SpdPnd98/EAWebSite/Characters_files/README.md

# Printed files

Below are the files we used to decorate our entertainment ship.

We have chosen a ```Pirate Theme``` to complement a fun and entertaining design

Credits to all the authors in Thingiverse that put their models in the public domain.
