SpdPnd98/EAWebSite/tim.md

### 11/02/2019

Team Bravo has finished making the battery indicator of the lipo battery pack

This battery indicator reads the voltage of the battery and shows its state by lighting up an LED in three different states

When we measured the battery at full charge, it reads 11.1V

We found that 3 batteries are in a lipo battery pack, hence the nominal voltage of one battery is 3.7V 

Components needed: 
                   
                   Stripboard
                   
                   Jumper wires
                   
                   82k resistor
                   
                   100k resistor 
                   
                   1 green led 

Since 11.1V cannot be supplied to the analog pin of the arduino because the pins can only receive an input of maximum 5 volts, we have decided to build a voltage divider with two resistors

Schematic of the circuit when simulated with a breadboard:

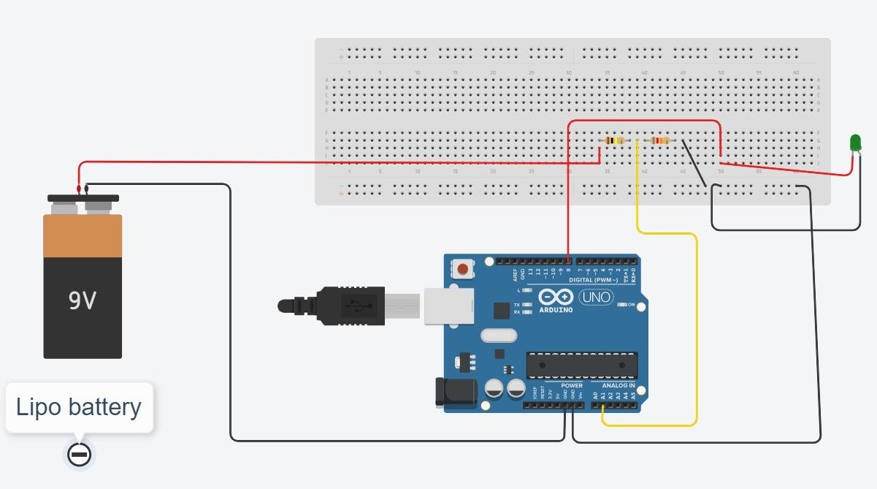
[picture p42: images/capture 4.JPG]
schematic


code of the program:

``` #define green 8

#define lipo  A1
 
float lipoV = 0;

void setup() {

pinMode(green,OUTPUT);
pinMode(lipo,INPUT);
Serial.begin(9600);
}
 
void loop() {
 
lipoV = analogRead(A1);

Serial.println(lipoV);
 
if(lipoV>777 && lipoV<838){
  digitalWrite(green, HIGH);   
  delay(250);                       
  digitalWrite(green, LOW);   
  delay(250);                       
}
if(lipoV>838 && lipoV<899){
  digitalWrite(green, HIGH);   
  delay(500);                     
  digitalWrite(green, LOW);    
  delay(500);                       
}
if(lipoV>899 && lipoV<1023){
 digitalWrite(green, HIGH);   
  delay(1000);                     
  digitalWrite(green, LOW);    
  delay(1000);    
}
}
```
From the code and schematic,

When the voltage is between 4.39 volts and 5 volts, the led turns on for 1s and off for 1s, indicating that the battery is fully charged

When the voltage is between 4.10 volts and 4.39 volts, the led turns on for 0.5s and off for 0.5s, indicating that the battery is half charged

When the voltage is between 3.8 volts and 4.10 volts, the led turns on for 0.25s and off for 0.25s, indicating that the battery is low in charge, prompting the user to charge the battery
