SpdPnd98/EAWebSite/BoatFinalReport/EA_program flow.png

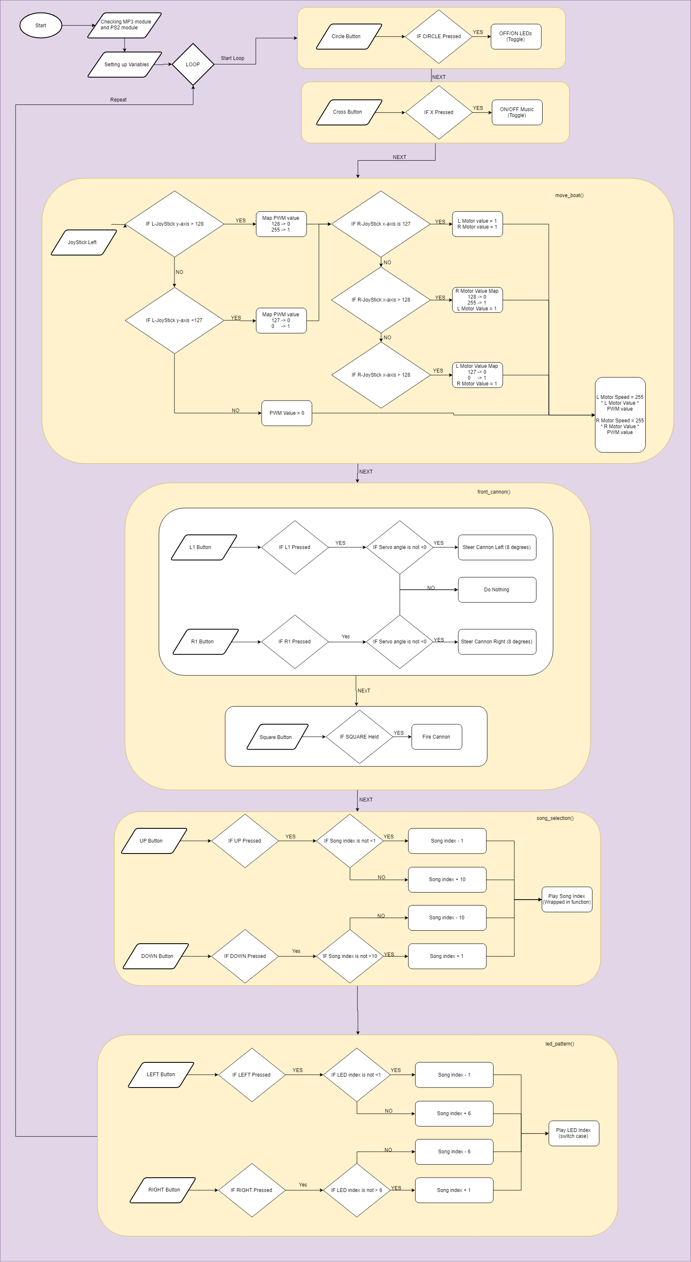
BoatFinalReport/EA_program flow.png
