SpdPnd98/EAWebSite/BoatFinalReport/Functional Requirements.png

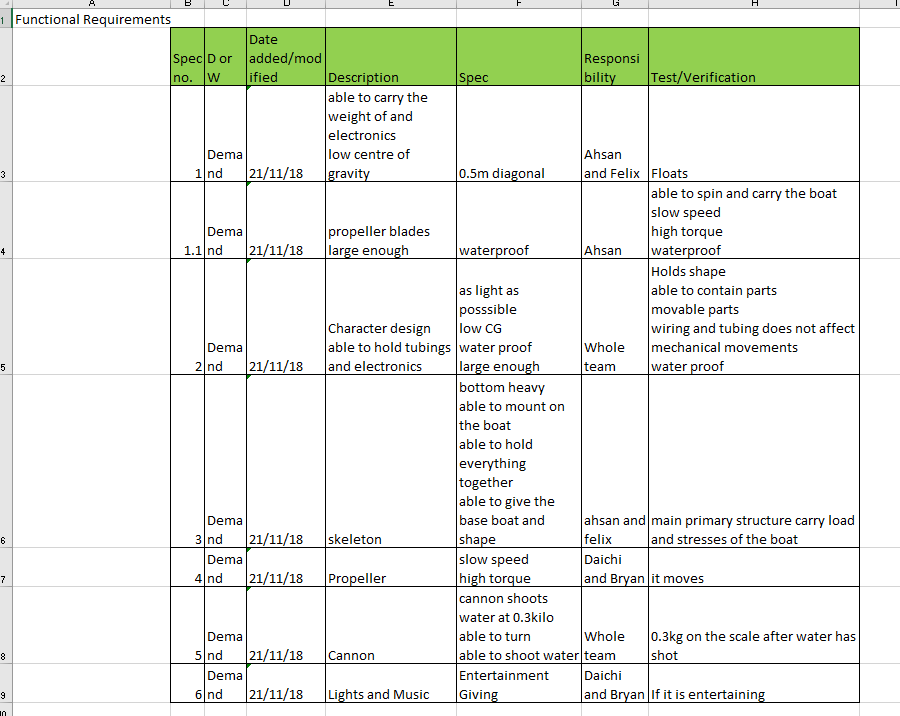
BoatFinalReport/Functional Requirements.png
