SpdPnd98/EAWebSite/images/Circuit Diagram.png

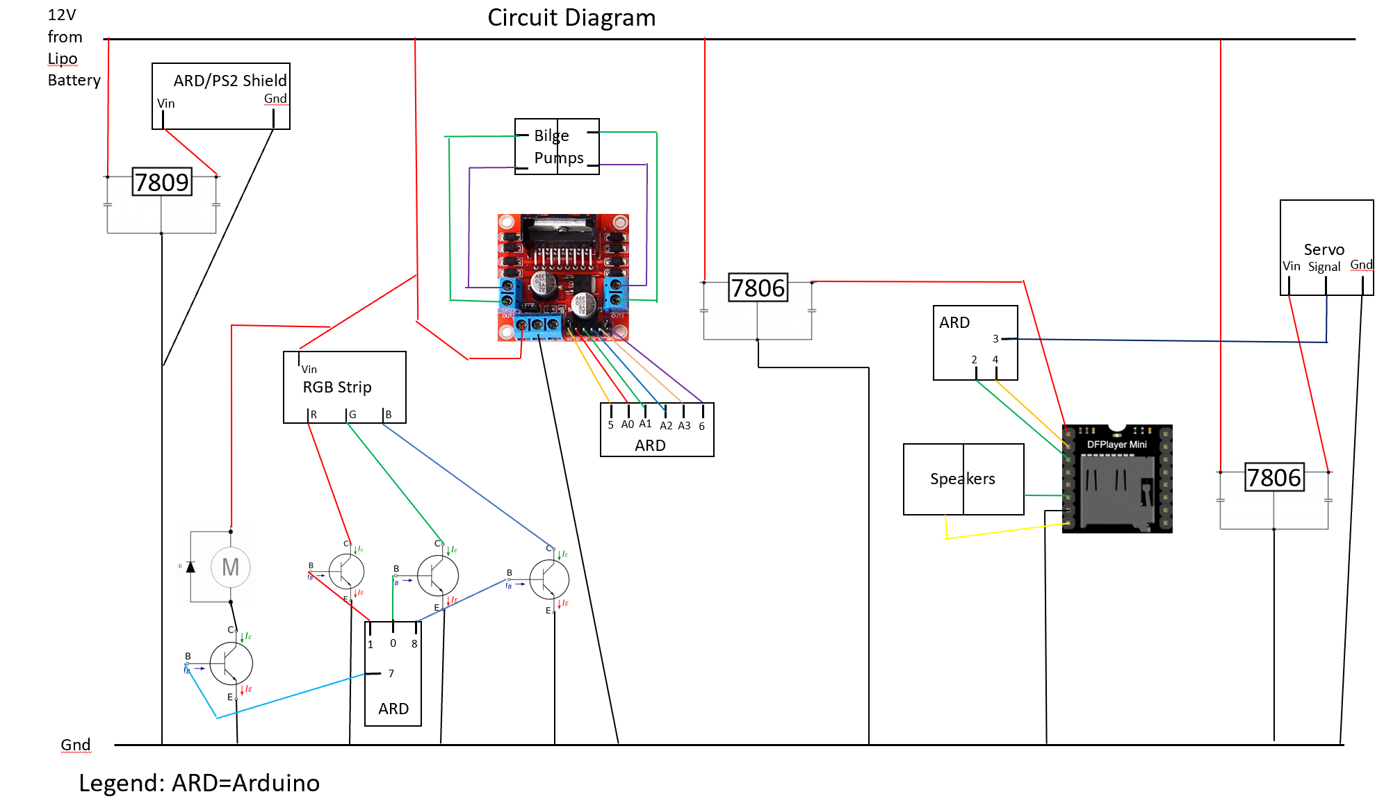
images/Circuit Diagram.png
