SpdPnd98/EAWebSite/(commit log)

2019-02-12 Late Commit
    Added Date we found the LED and the MP3 Module code
2019-02-12 Late Commits
    RGB Led and MP3 Module code
2019-02-12 Late Commits
    Brief Write Up on the RGB LEDs surrounding the boat
2019-02-12 Late commits
    Most of the tutorials here were done by yours truly as the main group was discussing on the water project solutions. Yours truly was in charge of finding the best communications protocol.
2019-02-12 Late Commit
    A Brief Description on the Power Requirement Lesson and Prototype Testing.
2019-02-12 bolts.jpg uploaded
2019-02-12 bolt.jpg uploaded
2019-02-17 Added EA_program flow.png
2019-02-17 Added image of EA_program flow
2019-02-17 updated current draw values
2019-02-18 changed EA_program flow.png
